lucy-chapar/evil-weather-machine/pcb/docs/pcb-back.png

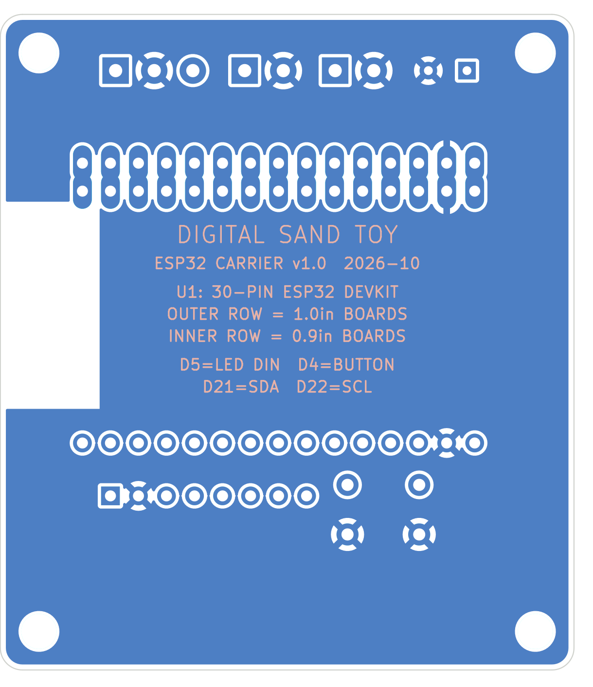
pcb/docs/pcb-back.png
