lucy-chapar/evil-weather-machine/pcb/docs/schematic.pdf

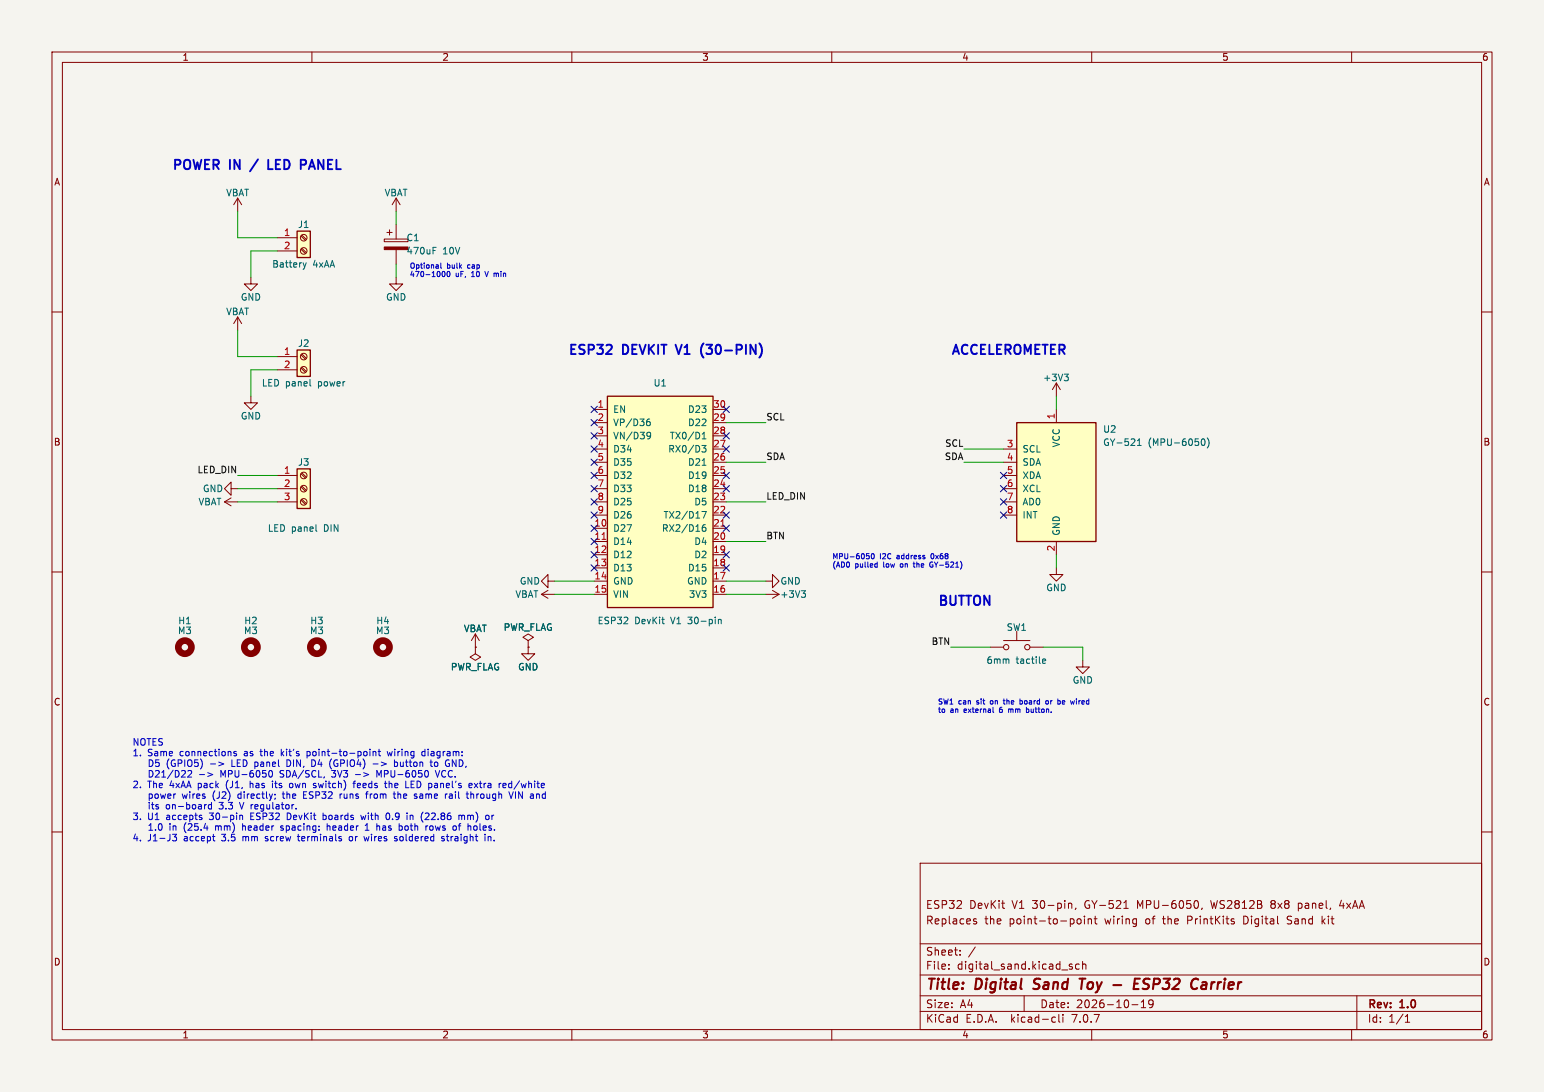
[picture p5: page 1]

POWER IN / LED PANEL

2 SCL 3 SDA 4 XDA 5 XCL 6 AD0 7

(AD0 pulled low on the GY-521) BUTTON

SW1 can sit on the board or be wired
