lucy-chapar/evil-weather-machine/pcb/digital_sand.kicad_pcb

## KiCad design pcb/digital_sand.kicad_pcb (2026-10-20)

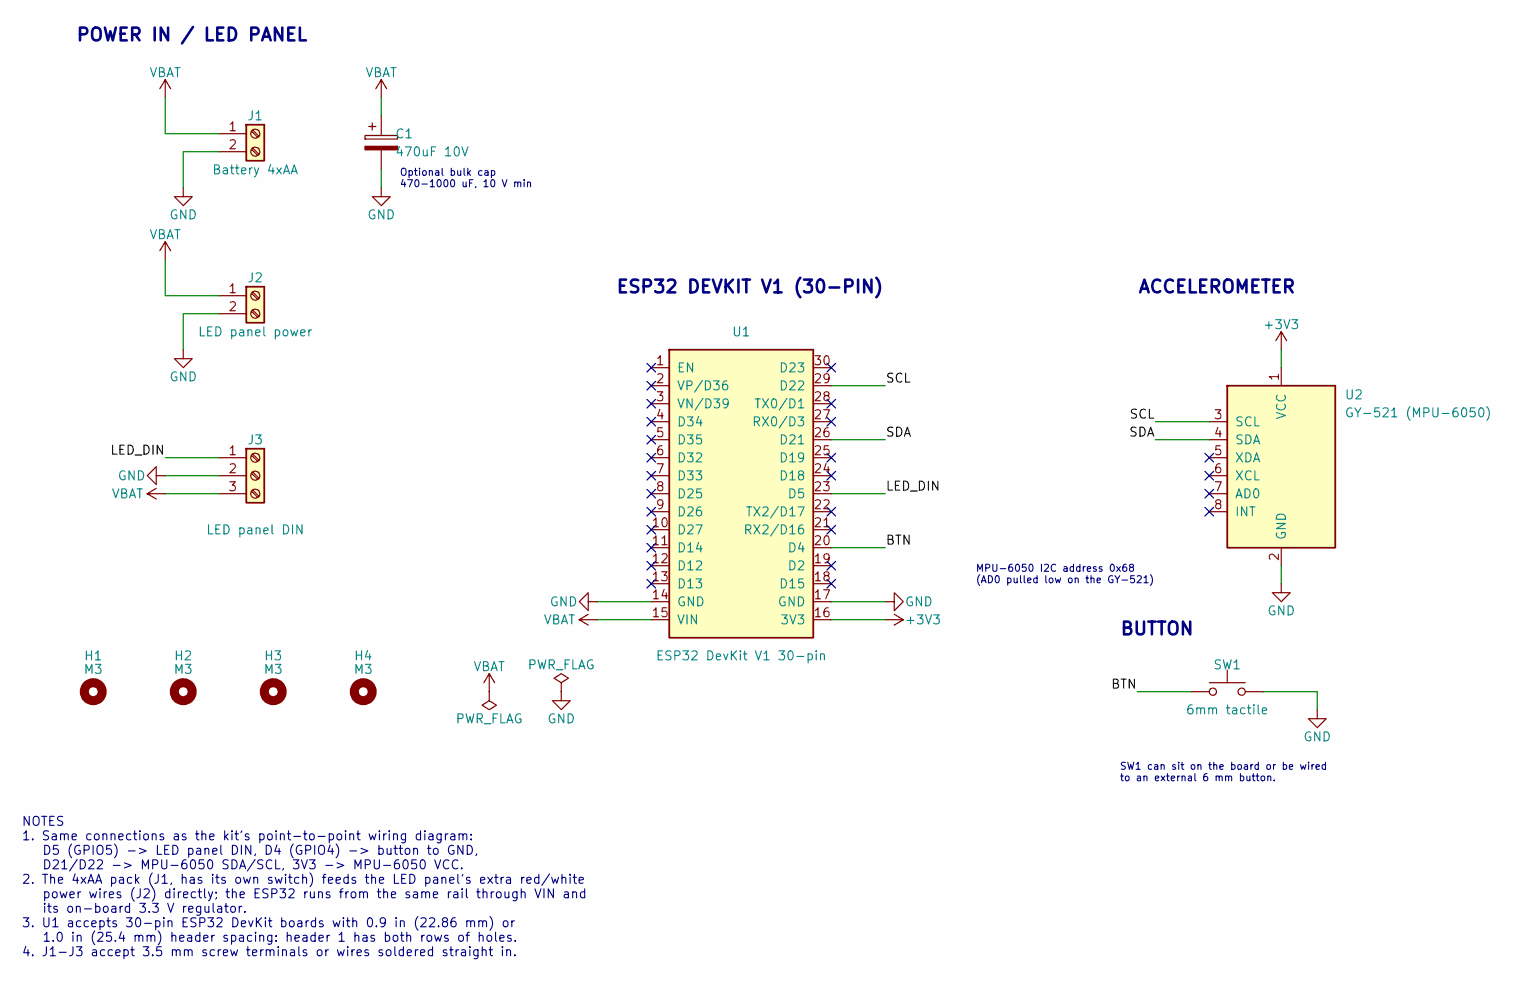
[picture p6: schematic digital_sand.kicad_sch, Digital Sand Toy - ESP32 Carrier]

Parts:
C1: 470uF 10V; CP_Radial_D8.0mm_P3.50mm
H1, H2, H3, H4: M3; MountingHole_3.2mm_M3
J1: Battery 4xAA; TerminalBlock_Phoenix_PT-1,5-2-3.5-H_1x02_P3.50mm_Horizontal
J2: LED panel power; TerminalBlock_Phoenix_PT-1,5-2-3.5-H_1x02_P3.50mm_Horizontal
J3: LED panel DIN; TerminalBlock_Phoenix_PT-1,5-3-3.5-H_1x03_P3.50mm_Horizontal
SW1: 6mm tactile; SW_PUSH_6mm
U1: ESP32 DevKit V1 30-pin; ESP32_DevKit_V1_30pin_DualRow
U2: GY-521 (MPU-6050); GY-521_MPU6050_Module

Connections:
+3V3: U1.16 (3V3), U2.1 (VCC)
/BTN: SW1.1, U1.20 (D4)
/LED_DIN: J3.1, U1.23 (D5)
/SCL: U1.29 (D22), U2.3 (SCL)
/SDA: U1.26 (D21), U2.4 (SDA)
GND: C1.2, J1.2, J2.2, J3.2, SW1.2, U1.14 (GND), U1.17 (GND), U2.2 (GND)
VBAT: C1.1, J1.1, J2.1, J3.3, U1.15 (VIN)

Notes on the sheet:
POWER IN / LED PANEL
ESP32 DEVKIT V1 (30-PIN)
ACCELEROMETER
BUTTON
Optional bulk cap 470-1000 uF, 10 V min
SW1 can sit on the board or be wired to an external 6 mm button.
MPU-6050 I2C address 0x68 (AD0 pulled low on the GY-521)
NOTES 1. Same connections as the kit's point-to-point wiring diagram: D5 (GPIO5) -> LED panel DIN, D4 (GPIO4) -> button to GND, D21/D22 -> MPU-6050 SDA/SCL, 3V3 -> MPU-6050 VCC. 2. The 4xAA pack (J1, has its own switch) feeds the LED panel's extra red/white power wires (J2) directly; the ESP32 runs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

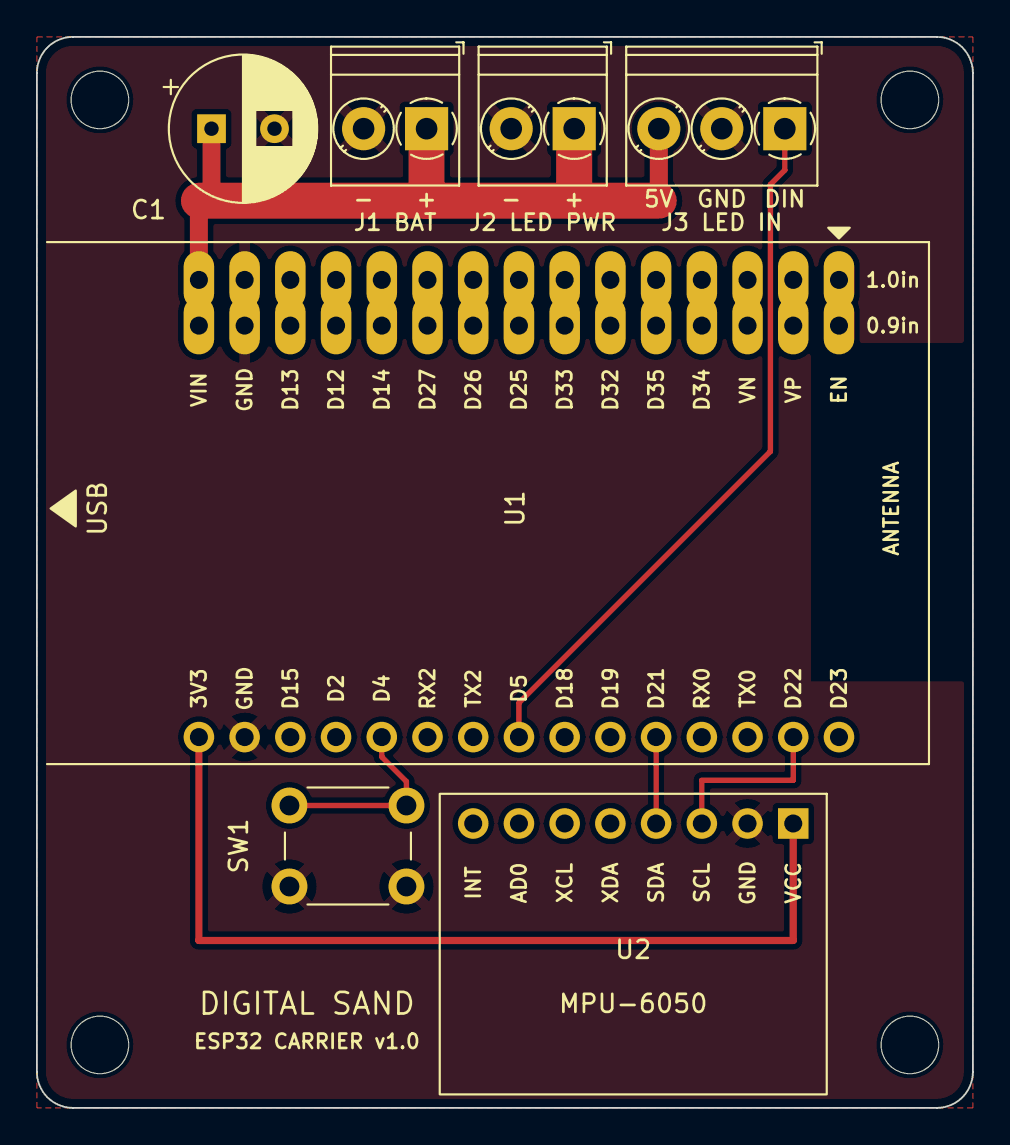
[picture p7: board digital_sand.kicad_pcb from above]

Board: 2 copper layers, 52.0 x 59.5 mm, 11 parts (0 on the bottom side), 7 nets.
