lucy-chapar/evil-weather-machine/(commit log)

2026-10-20 Carrier PCB and weather/shot-day firmware for the Digital Sand kit
    - pcb/: KiCad 7 two-layer board replacing the kit's point-to-point wiring,
    generated by tools/generate_kicad.py, with Gerbers and previews.
    - firmware/weather/: ESP32 firmware showing today's forecast (high/low,
    animated icon, rain chance) and an injection-day heart, with WiFi setup,
    OTA updates and a demo build.
    [digital_sand.kicad_pcb, digital_sand.kicad_sch]
2026-10-20 README: shot day, with feeling 💖
2026-10-23 Firmware: current conditions, moon phases, rain only when likely
    - New first screen: current temperature (number without an arrow).
    - The weather icon shows conditions right now instead of the day's worst
    weather code; the sun only by day, the moon in its current phase at night
    (with a cloud for partly cloudy nights).
    - Rain screen only when precipitation is at least 20% likely in the next
    12 hours (hourly data), instead of always, including dry days.
    - No loading spinner over the display on background refreshes; refresh every
    15 min; after 3 h without a successful fetch show the error screen rather
    than stale numbers.
    - Demo rewritten as a tagged list and extended with the new scr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
    [art.h, config.h, main.cpp]
